gabriel-603/EIUsat-1/relatorios/santa-maria/dados.xlsx

Sheet: log_0
Log | Equipe | Bateria | Temperatura | Pressao | Giroscopio x | Giro y | Giro z | Ace x | Ace y | Ace z | co2 | cam status
1 | 123 | 93 | 26.38 | 1002192 | -1465544 | -6528332 | 0.0 | 1723825 | 8140286 | 9868899 | 1062 | 1
2 | 123 | 94 | 27.42 | 1002295 | 1598775 | -9059726 | -2797856 | 2011129 | 1364695 | 9830592 | 1067 | 1
3 | 123 | 94 | 27.44 | 1002345 | -3996938 | -5196019 | -4396631 | 1819593 | 1651999 | 9880871 | 1058 | 1
4 | 123 | 94 | 27.49 | 1002293 | 1332313 | -3330781 | -4929556 | 2035071 | 1867477 | 9919178 | 1056 | 1
5 | 123 | 93 | 45.07 | 1002262 | 532925 | -3064319 | -3996938 | 2513912 | 1819593 | 9847352 | 1057 | 1
6 | 123 | 94 | 45.01 | 1002226 | -2398162 | -5728944 | -2797856 | 1843535 | 1221043 | 9830592 | 1061 | 1
7 | 123 | 94 | 45.16 | 1002228 | 1199081 | -5595713 | -1998469 | 2466028 | 1292869 | 9830592 | 1061 | 1
8 | 123 | 94 | 45.13 | 1002205 | 7993876 | -8926495 | -3996938 | 2011129 | 1316811 | 9832987 | 1057 | 1
9 | 123 | 94 | 27.17 | 1002256 | 1998469 | -7194488 | -3597244 | 2059013 | 1173159 | 9868899 | 1061 | 1
10 | 123 | 94 | 27.22 | 1002174 | -2264931 | -8127107 | -2264931 | 2226608 | 1149217 | 9801862 | 1062 | 1
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
