gabriel-603/EIUsat-1/codigos/fluxogramas/fluxograma de codigo (1).png

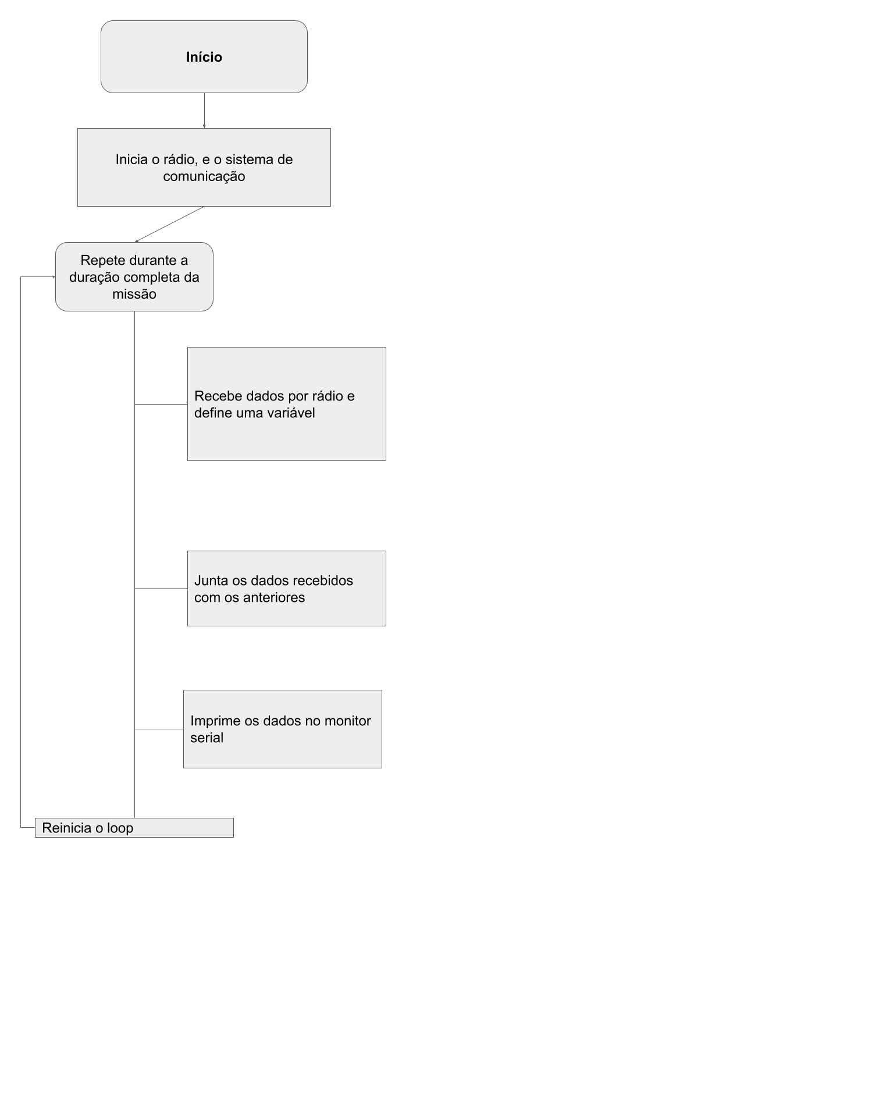
codigos/fluxogramas/fluxograma de codigo (1).png
