gabriel-603/EIUsat-1/codigos/fluxogramas/fluxograma de codigo.jpg

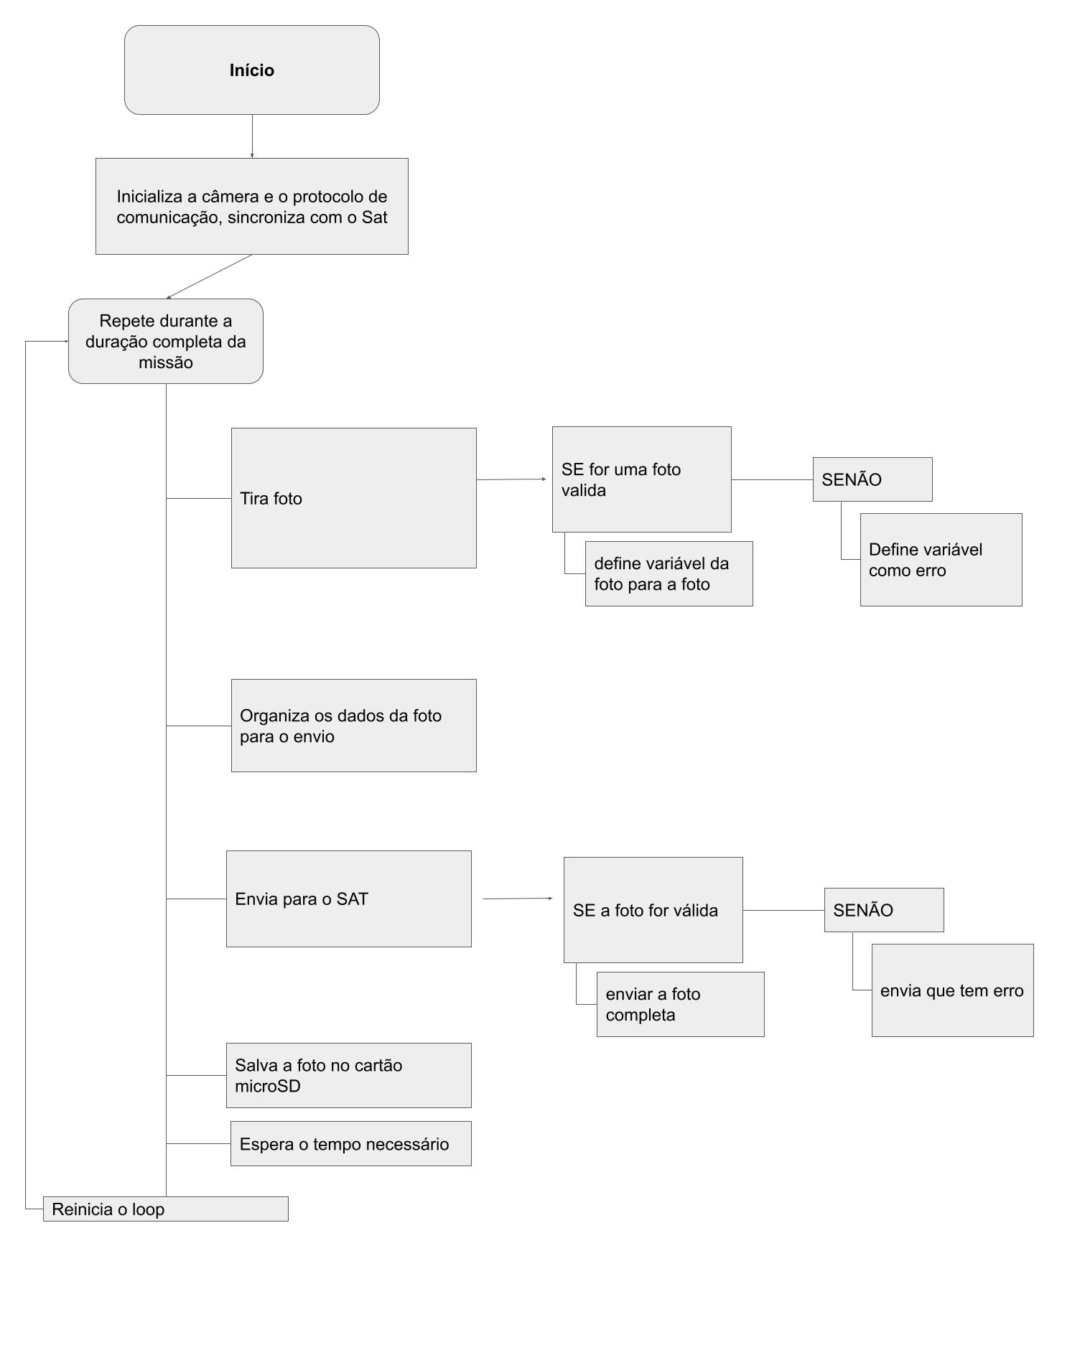
codigos/fluxogramas/fluxograma de codigo.jpg
