gabriel-603/EIUsat-1/codigos/fluxogramas/fluxograma de codigo.png

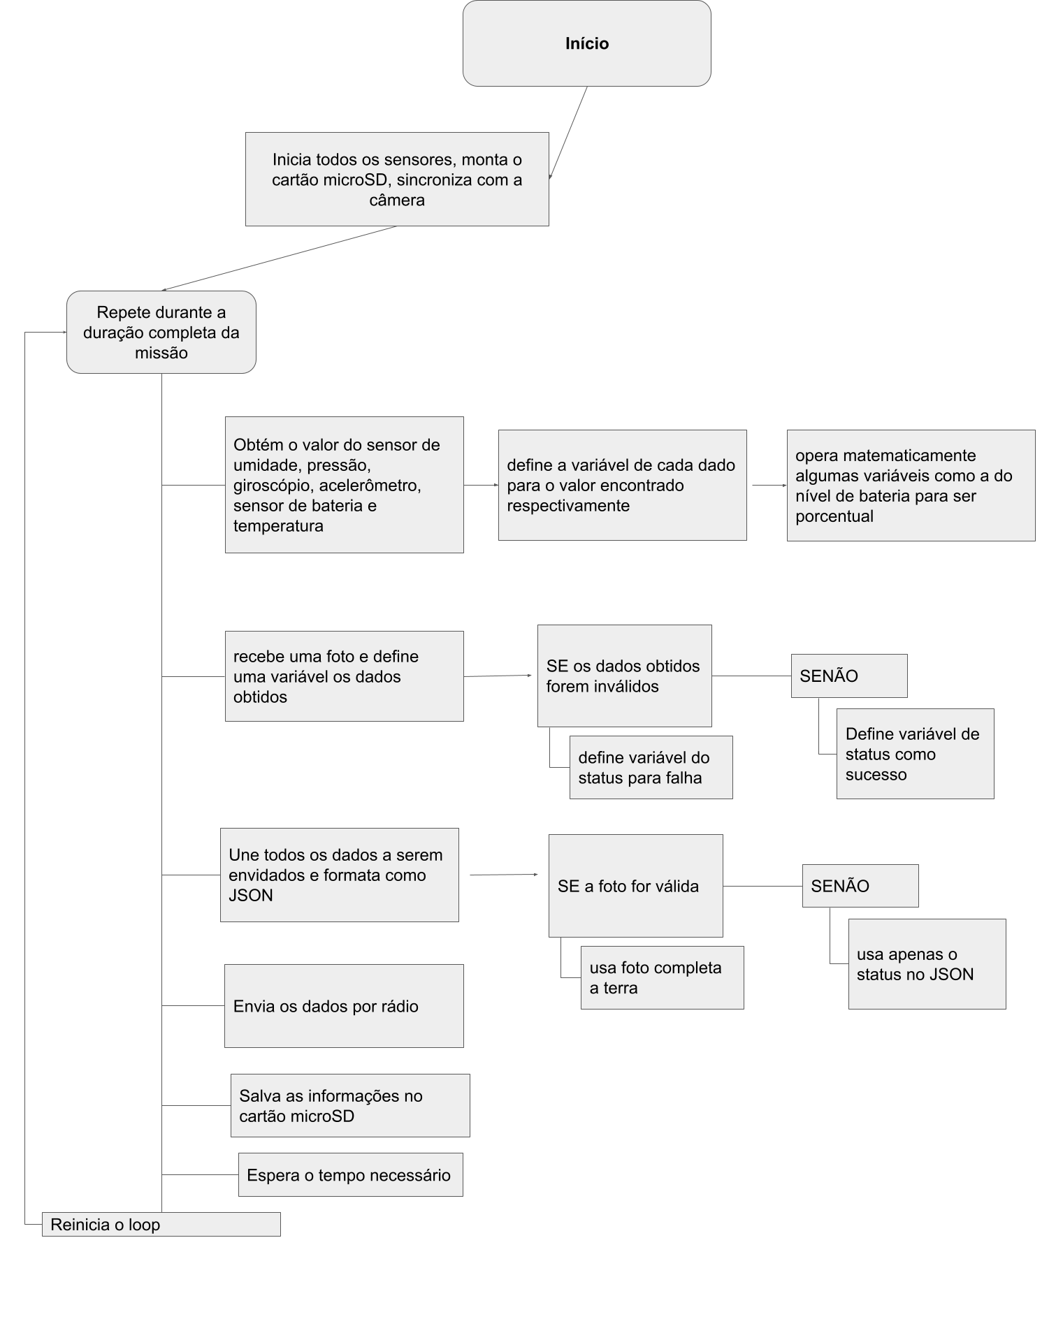
codigos/fluxogramas/fluxograma de codigo.png
