gabriel-603/EIUsat-1/relatorios/santa-maria/dados - log_0.pdf

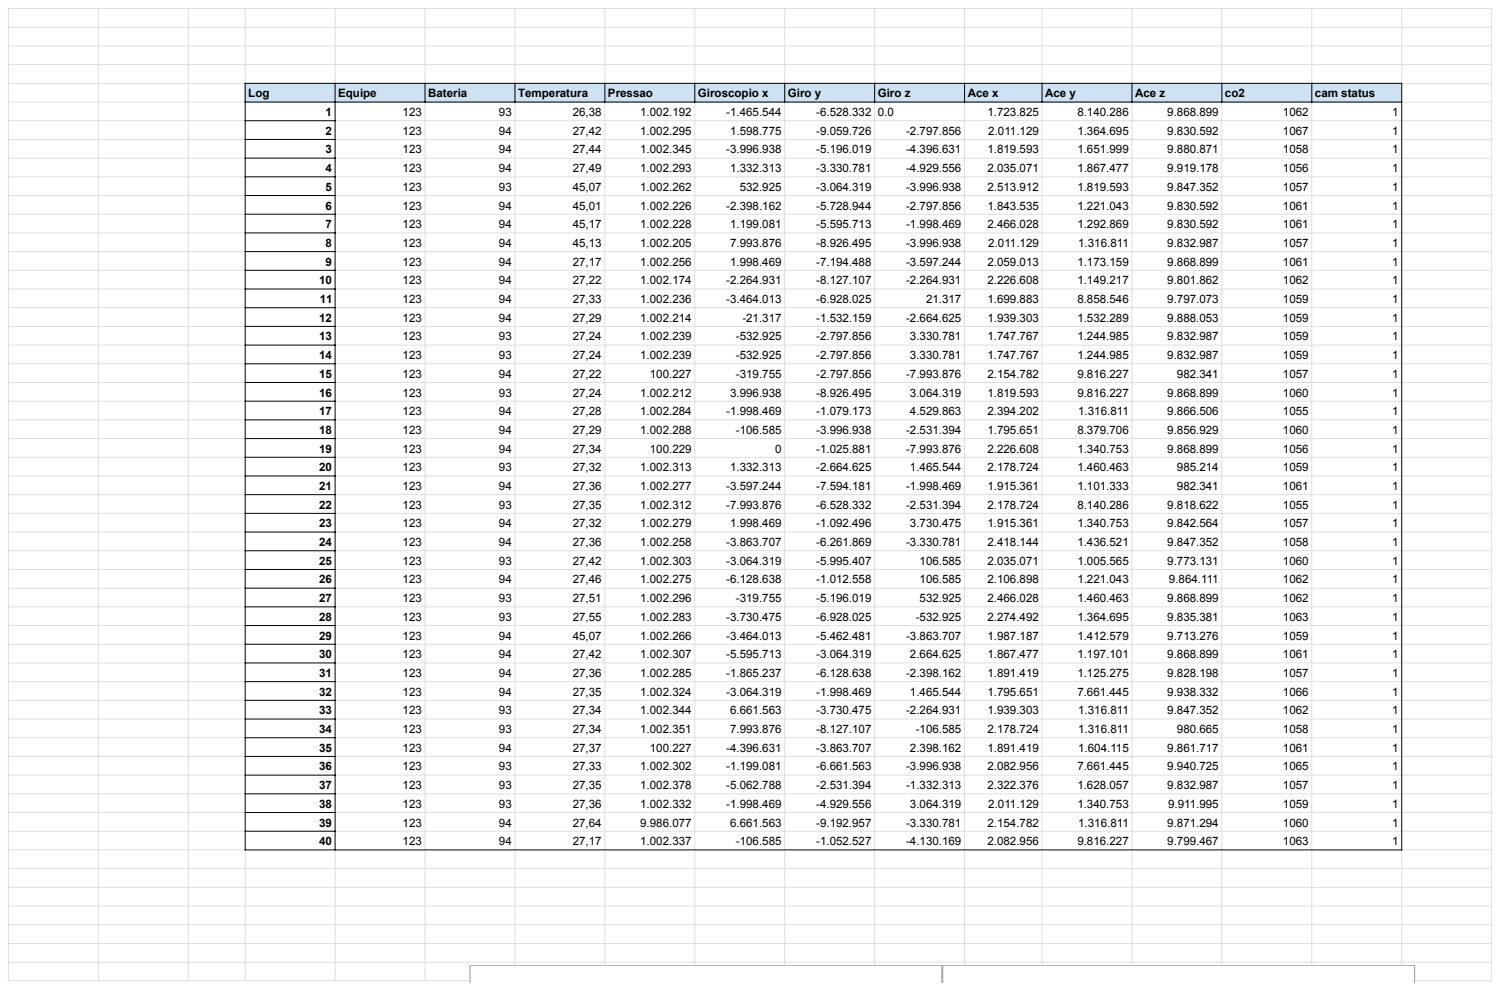
[picture p21: page 1]
Log; Equipe; Bateria; Temperatura; Pressao; Giroscopio x; Giro y; Giro z; Ace x; Ace y; Ace z; cam status

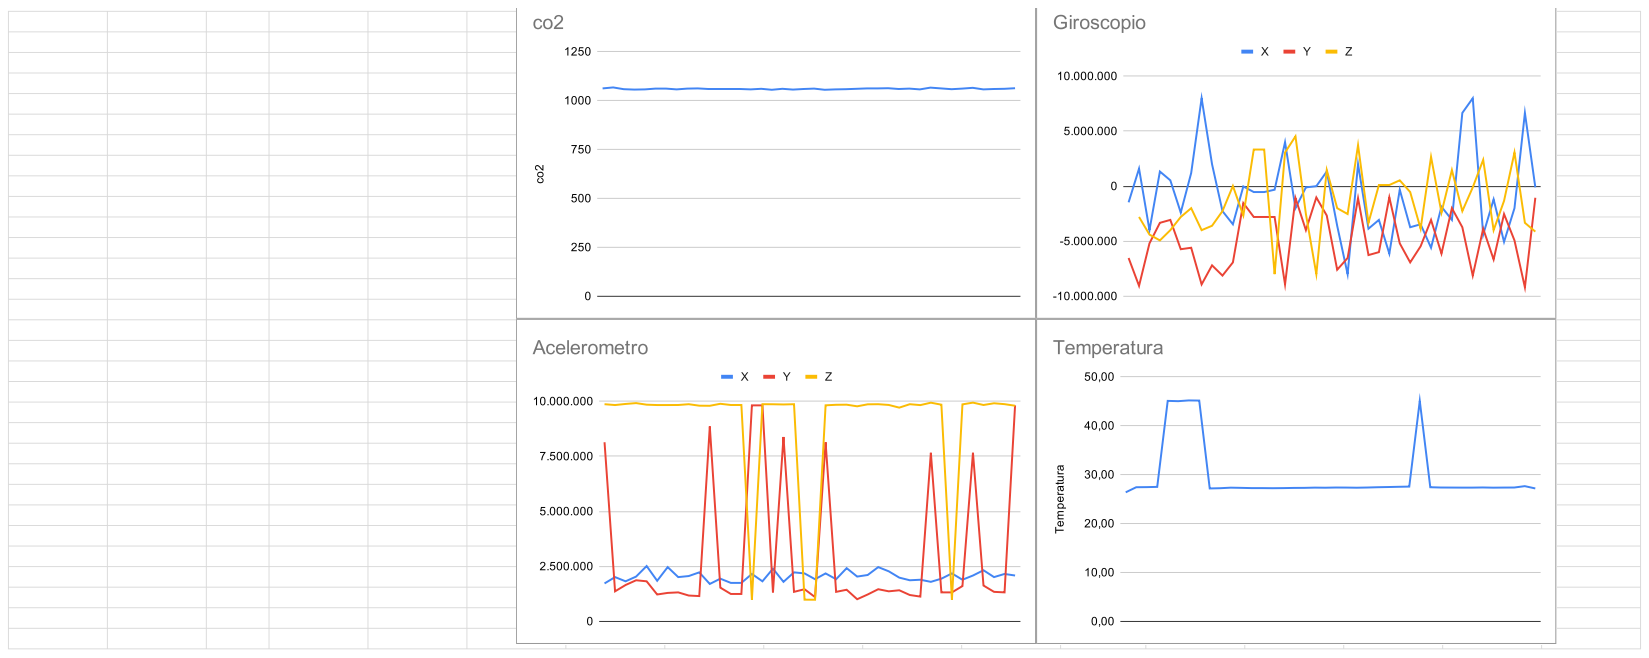
[picture p22: page 2]
