gabriel-603/EIUsat-1/relatorios/EIUsat-estruturaplanificada - Model.pdf

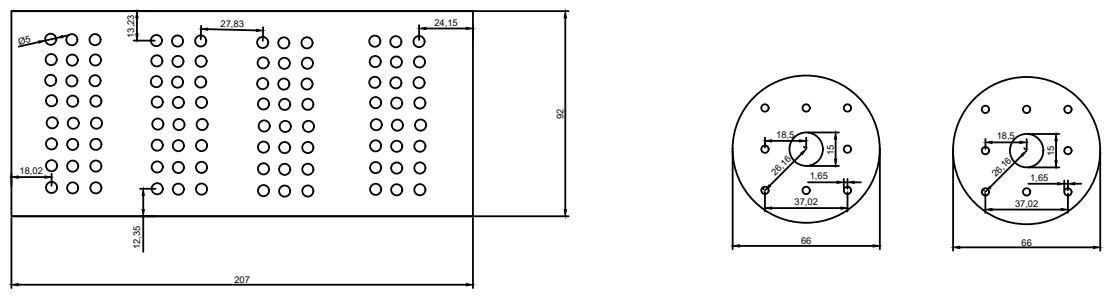
[picture p23: page 1]
