gabriel-603/EIUsat-1/(commit log)

2023-12-02 Update EIUsat-CAM.ino
    / use webserver pre made sample and alter main file
2026-01-05 added report on antenna specs for mit portfolio
